douglassanoja/PLCUSB/CAM00172.jpg

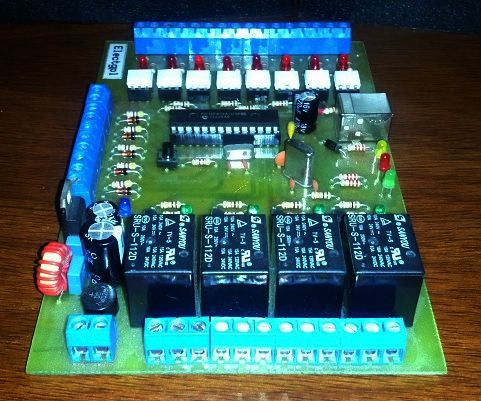
CAM00172.jpg
