douglassanoja/PLCUSB/CAM00173.jpg

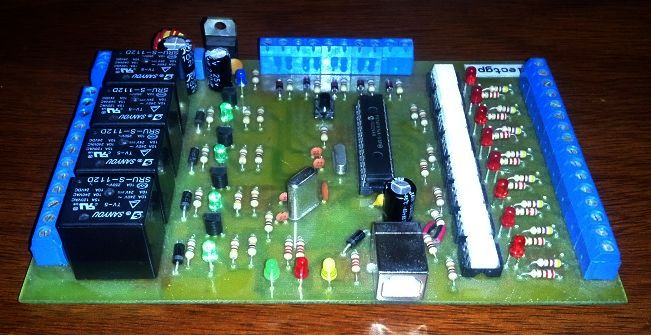
CAM00173.jpg
