douglassanoja/PLCUSB/CAM00174.jpg

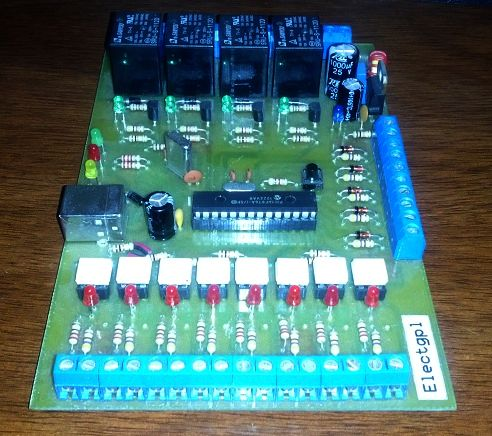
CAM00174.jpg
