douglassanoja/PLCUSB/CAM00176.jpg

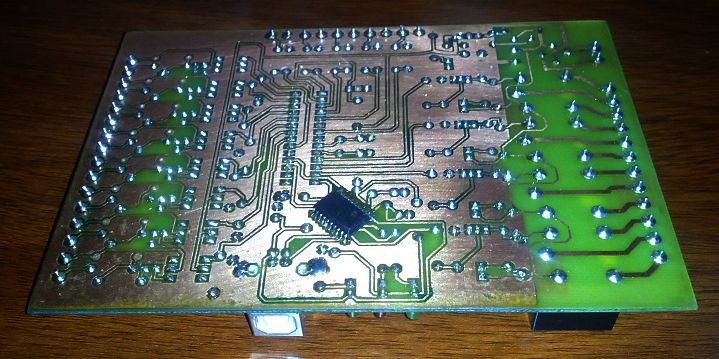
CAM00176.jpg
