douglassanoja/PLCUSB/CAM00177.jpg

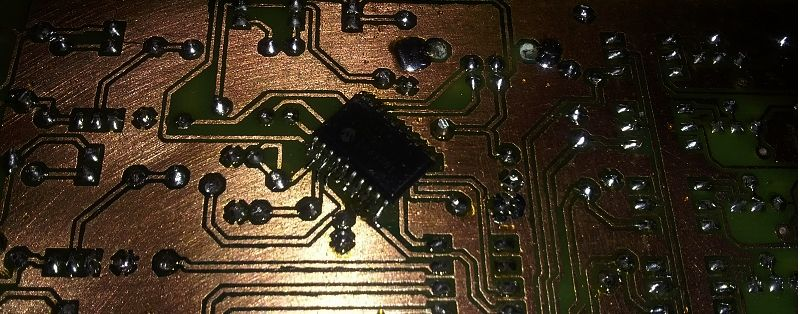
CAM00177.jpg
