douglassanoja/PLCUSB/CAM00180.jpg

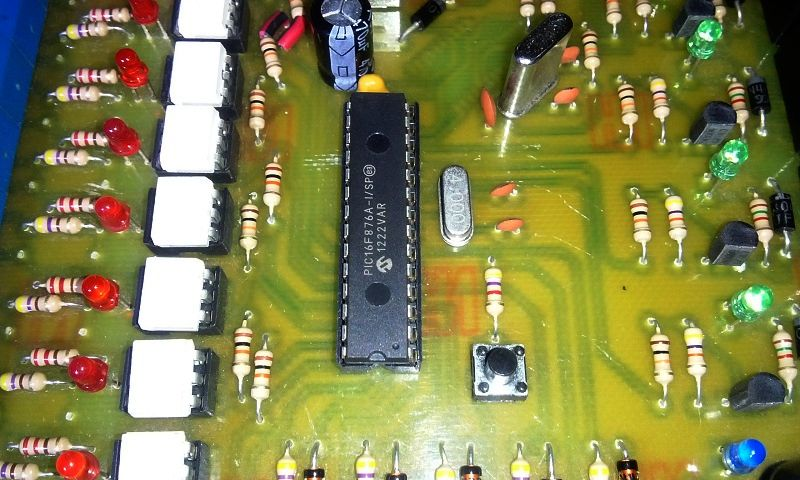
CAM00180.jpg
