douglassanoja/PLCUSB/PLCUSB_3D.PNG

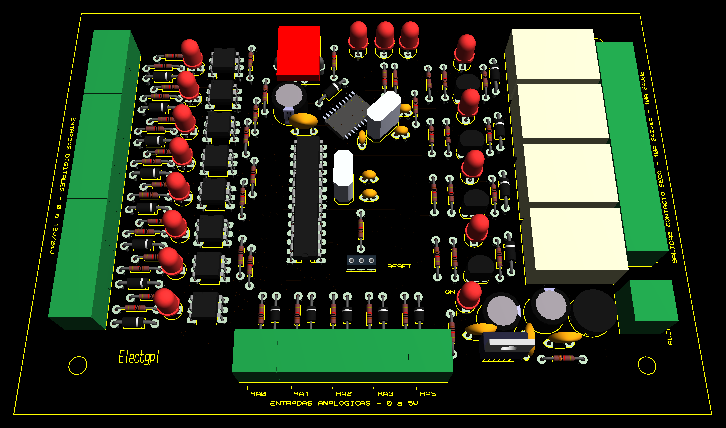
PLCUSB_3D.PNG
