douglassanoja/PLCUSB/PLCUSB_COMP.PNG

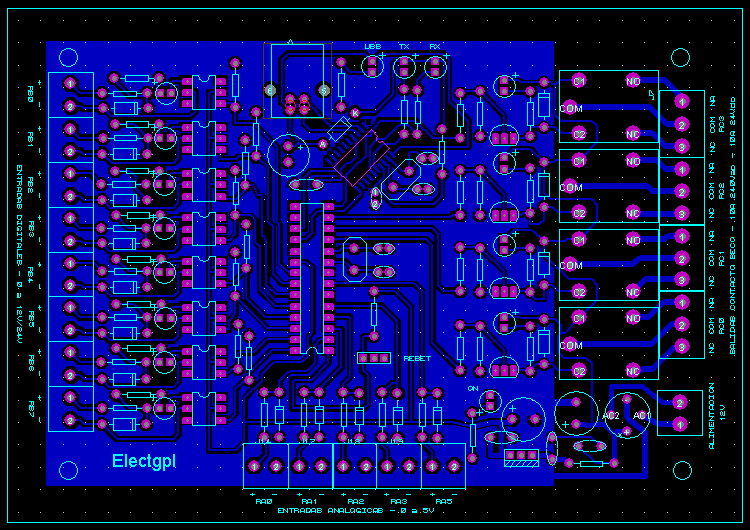
PLCUSB_COMP.PNG
