douglassanoja/PLCUSB/PLCUSB_PCB.PNG

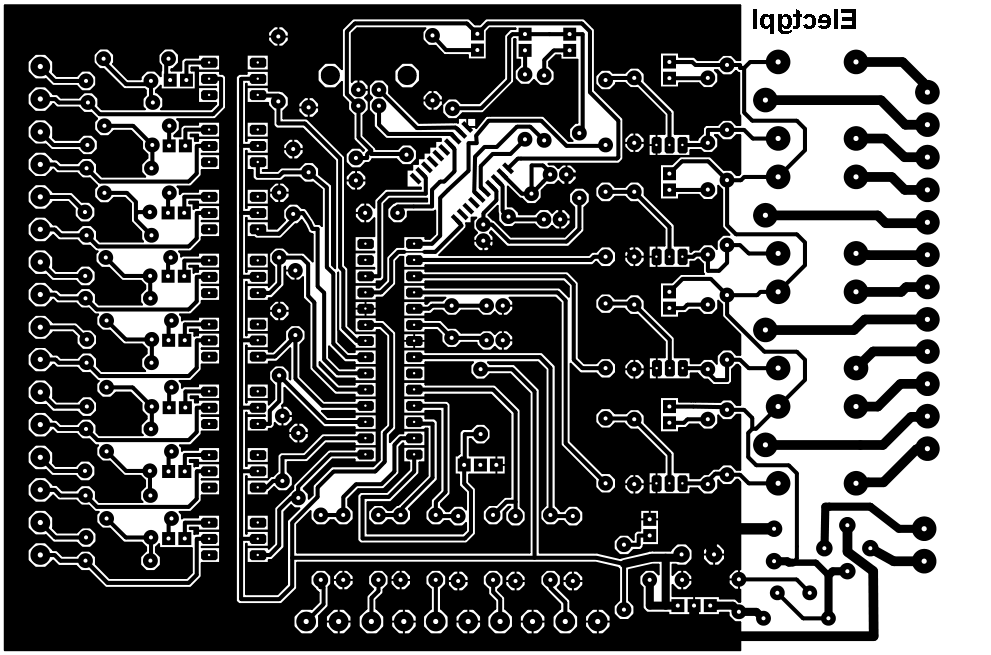
PLCUSB_PCB.PNG
