douglassanoja/PLCUSB/PLCUSB_SCH.PNG

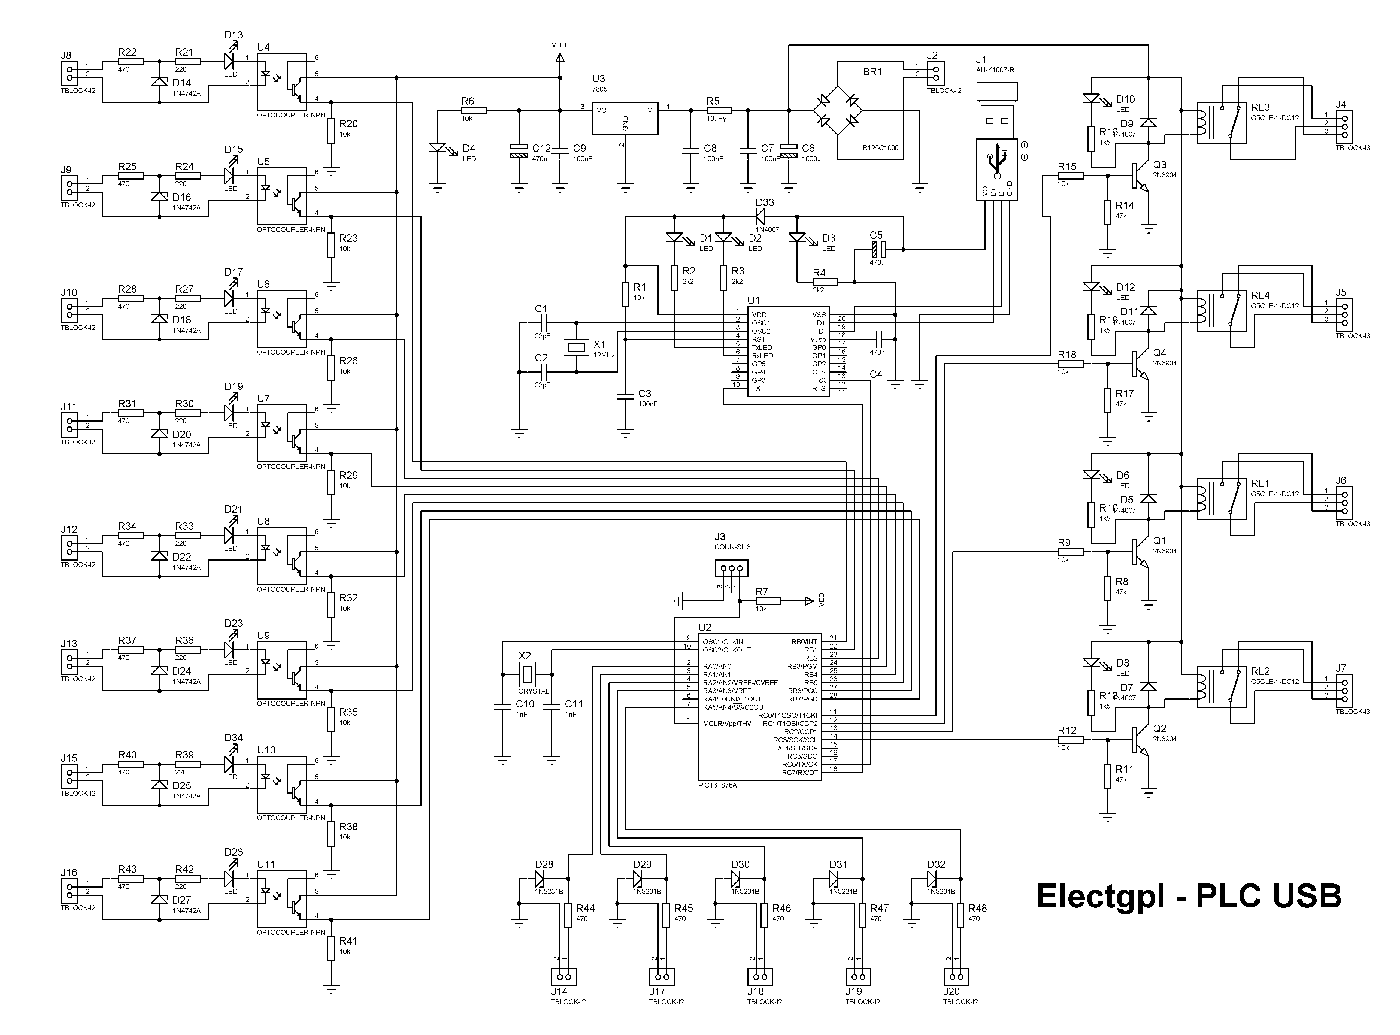
PLCUSB_SCH.PNG
