douglassanoja/PLCUSB/Bill Of Materials For PLC USB.HTML

Bill Of Materials For PLC USB.DSN
Design Title | : | PLC USB.DSN
Author | : | <NONE>
Revision | : | <NONE>
Design Created | : | sábado, 24 de noviembre de 2012
Design Last Modified | : | viernes, 27 de diciembre de 2013
Total Parts In Design | : | 136
48 Resistors
 | Quantity: |  | References | Value | Order Code
 | 15 |  | R1, R6, R7, R9, R12, R15, R18, R20, R23, R26, R29, R32, R35, R38, R41 | 10k
 | 3 |  | R2-R4 | 2k2
 | 1 |  | R5 | 10uHy | M13K
 | 4 |  | R8, R11, R14, R17 | 47k
 | 4 |  | R10, R13, R16, R19 | 1k5
 | 8 |  | R21, R24, R27, R30, R33, R36, R39, R42 | 220
 | 13 |  | R22, R25, R28, R31, R34, R37, R40, R43-R48 | 470
12 Capacitors
 | Quantity: |  | References | Value | Order Code
 | 2 |  | C1, C2 | 22pF
 | 4 |  | C3, C7-C9 | 100nF
 | 1 |  | C4 | 470nF
 | 1 |  | C5 | 470u | Maplin VH38R
 | 1 |  | C6 | 1000u | Maplin VH50E
 | 2 |  | C10, C11 | 1nF
 | 1 |  | C12 | 470u | Maplin VH50E
11 Integrated Circuits
 | Quantity: |  | References | Value | Order Code
 | 1 |  | U1
 | 1 |  | U2 | PIC16F876A
 | 1 |  | U3 | 7805
 | 8 |  | U4-U11 | OPTOCOUPLER-NPN
4 Transistors
 | Quantity: |  | References | Value | Order Code
 | 4 |  | Q1-Q4 | 2N3904
34 Diodes
 | Quantity: |  | References | Value | Order Code
 | 16 |  | D1-D4, D6, D8, D10, D12, D13, D15, D17, D19, D21, D23, D26, D34 | LED
 | 5 |  | D5, D7, D9, D11, D33 | 1N4007
 | 8 |  | D14, D16, D18, D20, D22, D24, D25, D27 | 1N4742A
 | 5 |  | D28-D32 | 1N5231B
27 Miscellaneous
 | Quantity: |  | References | Value | Order Code
 | 1 |  | BR1 | B125C1000
 | 1 |  | J1 | AU-Y1007-R | Digikey AE9925-ND
 | 14 |  | J2, J8-J20 | TBLOCK-I2
 | 1 |  | J3 | CONN-SIL3
 | 4 |  | J4-J7 | TBLOCK-I3
 | 4 |  | RL1-RL4 | G5CLE-1-DC12
 | 1 |  | X1 | 12MHz
 | 1 |  | X2 | CRYSTAL
viernes, 27 de abril de 2018 12:40:19
