douglassanoja/PLCUSB/PLC USB A4.pdf

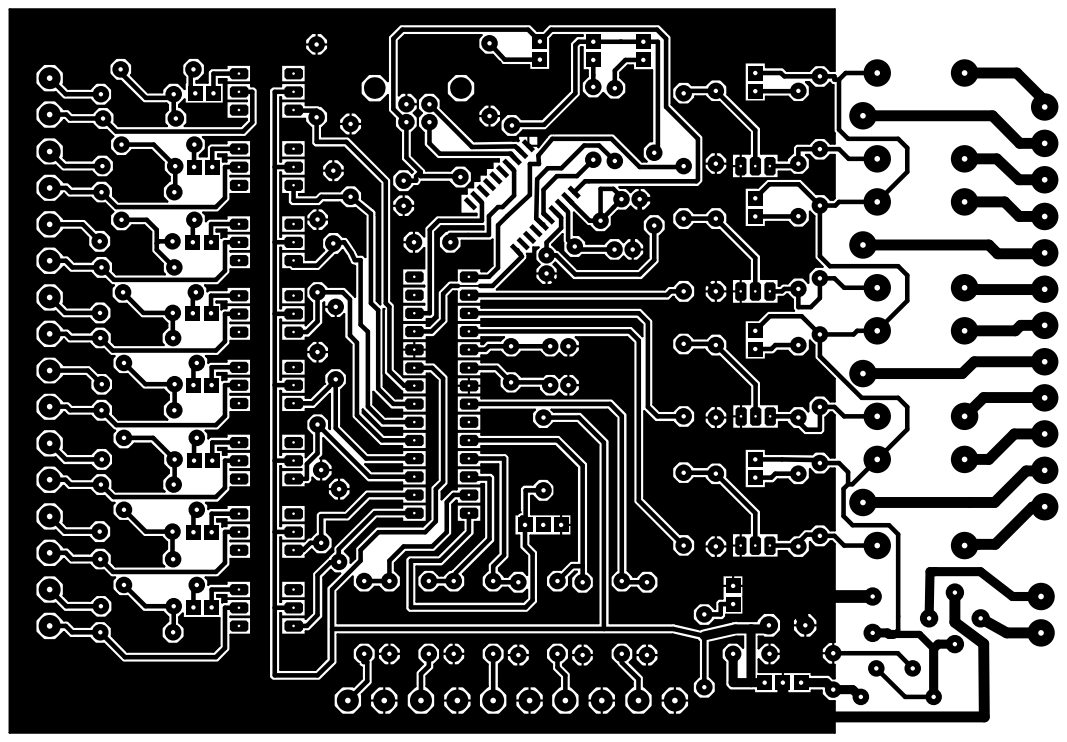
[picture p12: page 1]
