douglassanoja/PLCUSB/(list of files, drawings)

Other design files:
PLC USB.DSN
PLC USB.LYT
